BreinyFS/Breiny_Feliz_Electiva_2025_C1/Tareas clase #1/Resumen Cap 1 y 2 - Breiny Feěliz.pdf

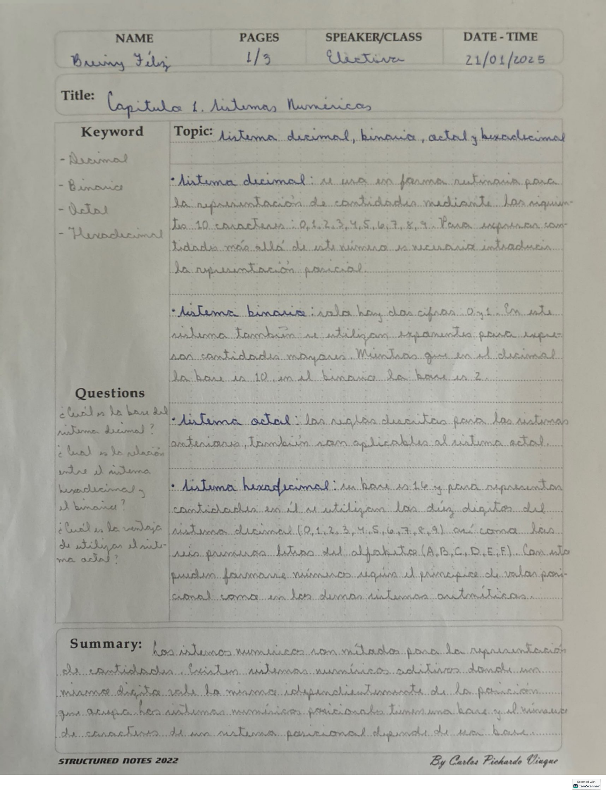
[picture p1: page 1]
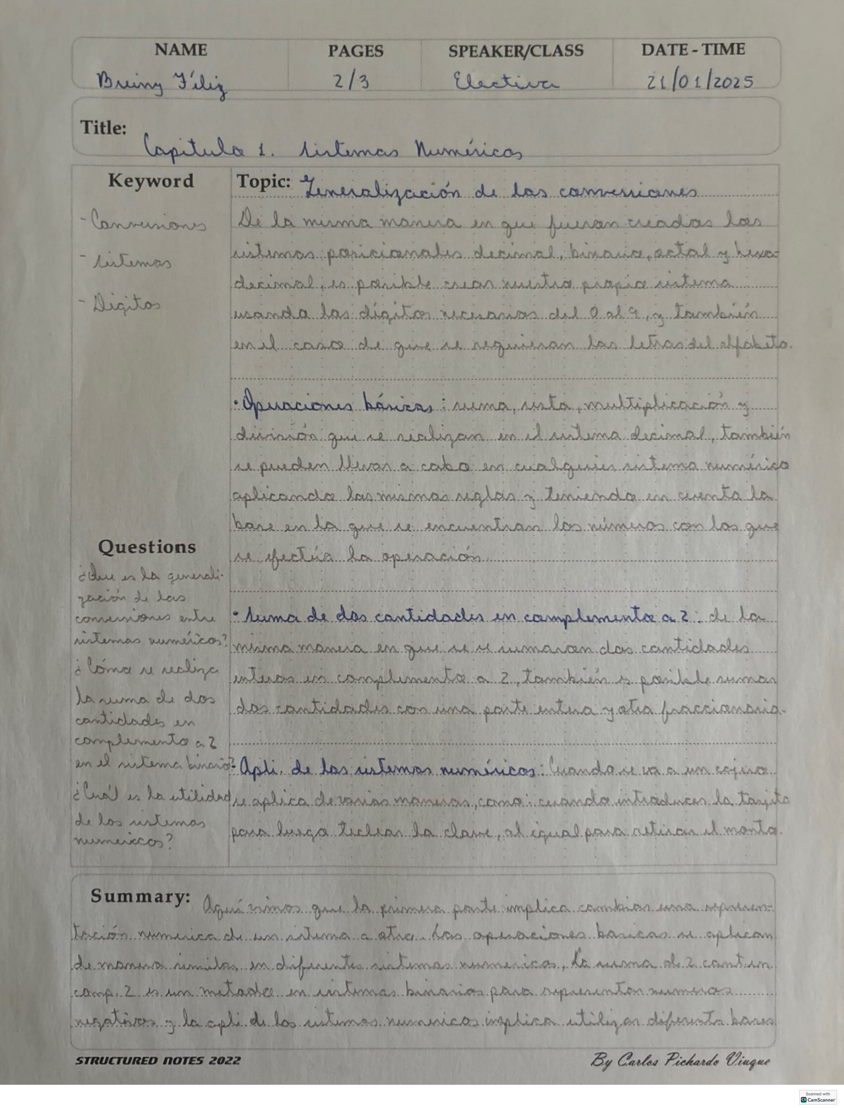
[picture p2: page 2]
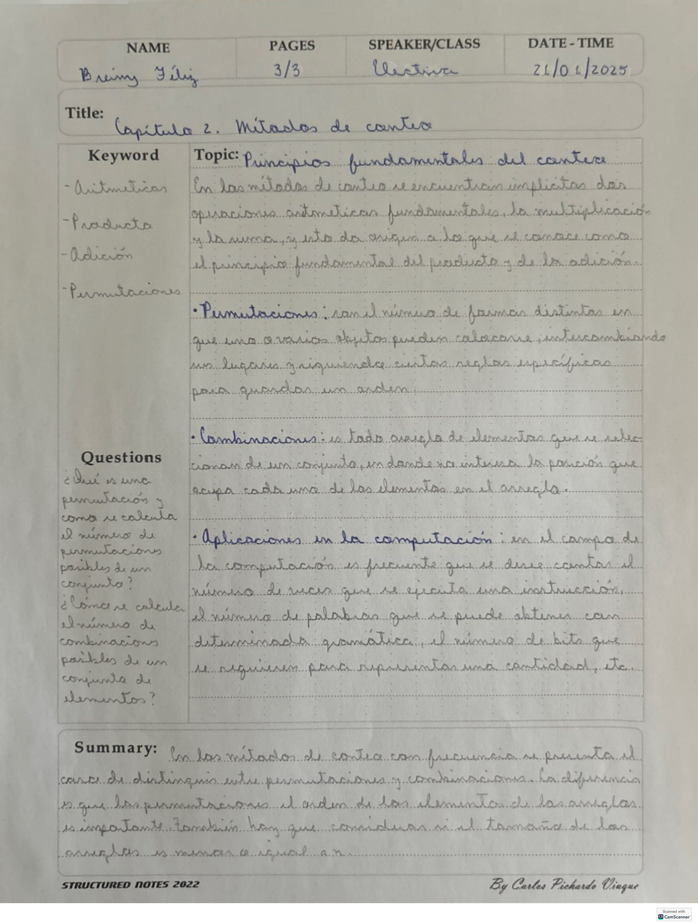
[picture p3: page 3]
