BreinyFS/Breiny_Feliz_Electiva_2025_C1/Tarea Final/Diseno en FreeCad/Parte Superior.FCStd

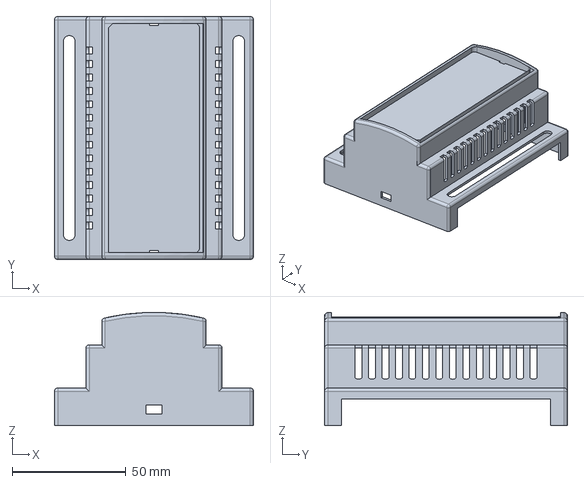
[picture p4: CAD file, 2025-04-25]
Tarea Final/Diseno en FreeCad/Parte Superior.FCStd
87.7 x 107.0 x 49.8 mm
