BreinyFS/Breiny_Feliz_Electiva_2025_C1/Tarea Final/Diseno en FreeCad/Parte Inferior.FCStd

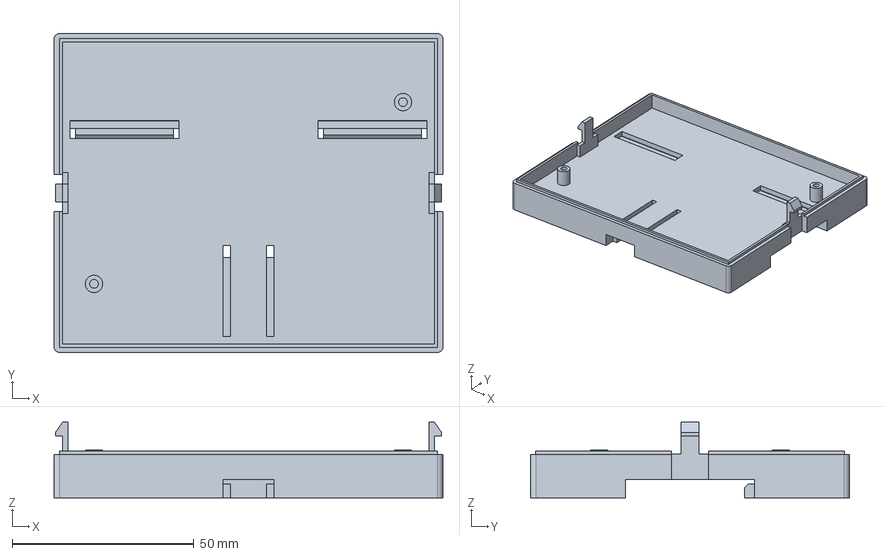
[picture p5: CAD file, 2025-04-22]
Tarea Final/Diseno en FreeCad/Parte Inferior.FCStd
107.0 x 87.7 x 20.8 mm
