BreinyFS/Breiny_Feliz_Electiva_2025_C1/Tarea #3/Aislador/Aislador.kicad_pcb

## KiCad design Tarea #3/Aislador/Aislador.kicad_pcb (2025-04-05)

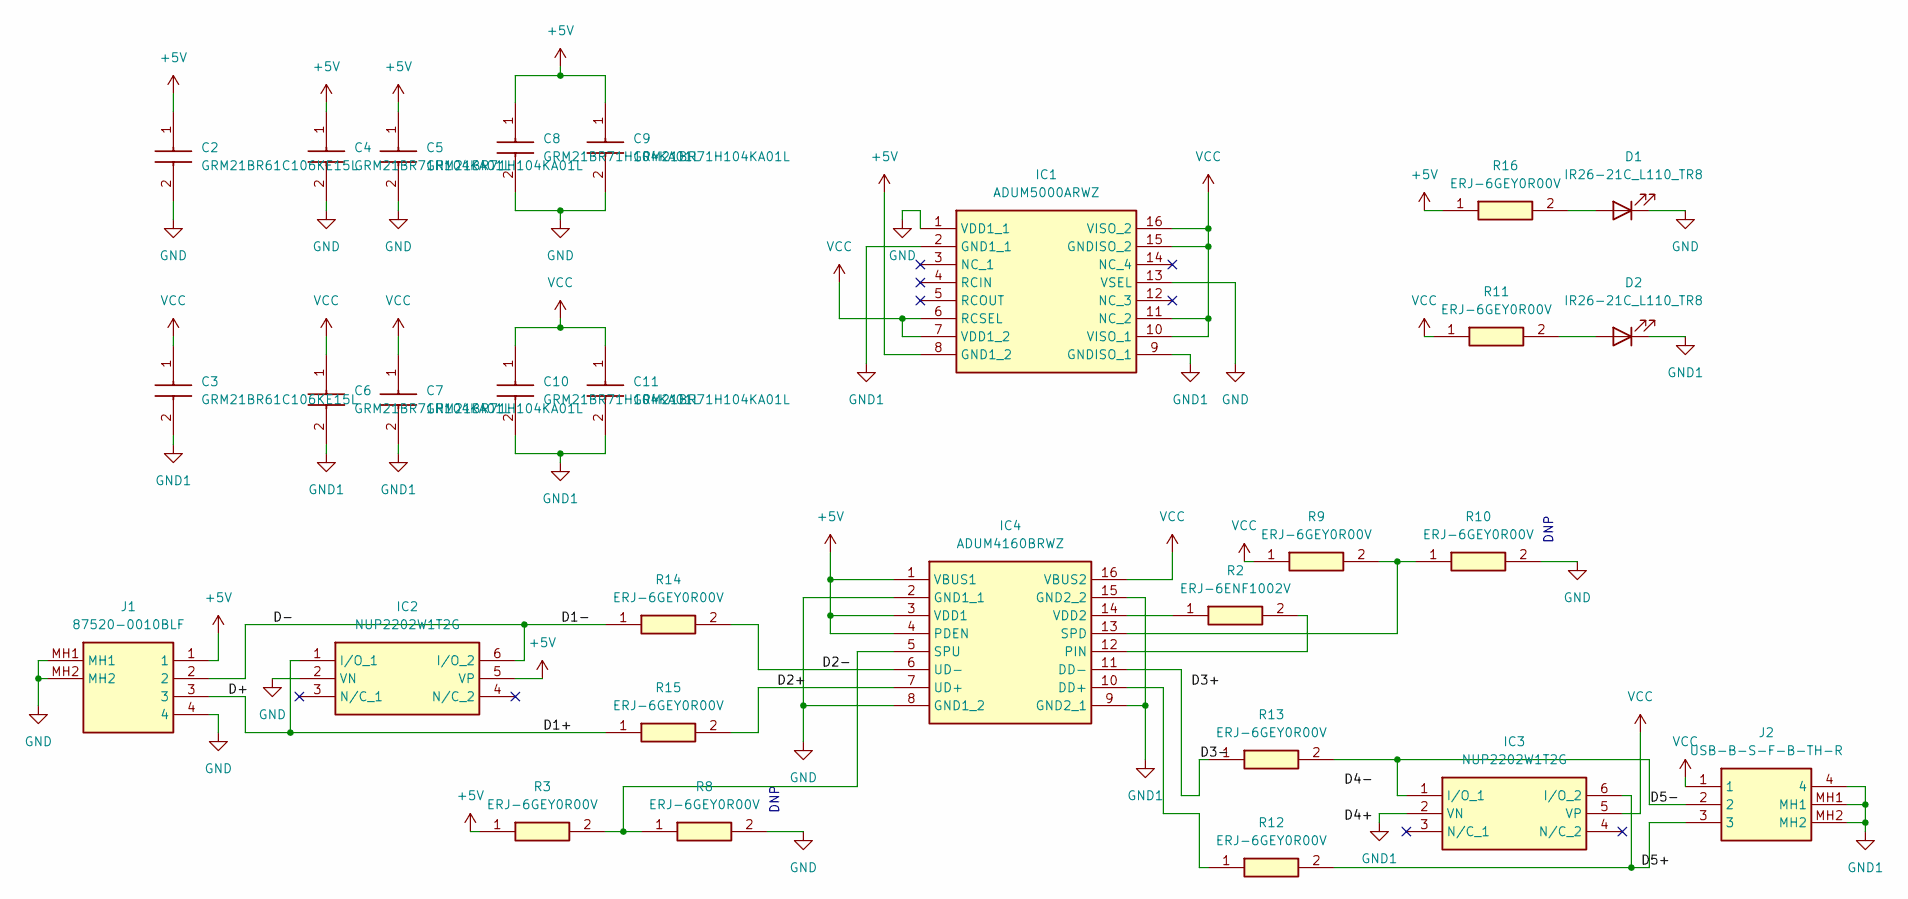
[picture p6: schematic Aislador.kicad_sch, Aislador USB]

Parts:
C2, C3: GRM21BR61C106KE15L; CAPC2012X145N; Manufacturer_Part_Number GRM21BR61C106KE15L; Mouser Part Number 81-GRM21BR61C106KE15
C4, C5, C6, C7, C8, C9, C10, C11: GRM21BR71H104KA01L; CAPC2012X145N; Manufacturer_Part_Number GRM21BR71H104KA01L; Mouser Part Number 81-GRM40X104K50L
D1, D2: IR26-21C_L110_TR8; LED_1206_3216Metric
IC1: ADUM5000ARWZ; SOIC127P1032X265-16N; Manufacturer_Part_Number ADUM5000ARWZ; Mouser Part Number 584-ADUM5000ARWZ
IC2, IC3: NUP2202W1T2G; SOT65P210X110-6N; Manufacturer_Part_Number NUP2202W1T2G; Mouser Part Number 863-NUP2202W1T2G
IC4: ADUM4160BRWZ; SOIC127P1032X265-16N; Manufacturer_Part_Number ADUM4160BRWZ; Mouser Part Number 584-ADUM4160BRWZ
J1: 87520-0010BLF; 875200010BLF; Manufacturer_Part_Number 87520-0010BLF
J2: USB-B-S-F-B-TH-R; USBBSFBTHR; Manufacturer_Part_Number USB-B-S-F-B-TH-R; Mouser Part Number 200-USBBSFBTHR
R2: ERJ-6ENF1002V; ERJ6ENF1000V; Manufacturer_Part_Number ERJ-6ENF1002V; Mouser Part Number 667-ERJ-6ENF1002V
R3, R8, R9, R10, R11, R12, R13, R14, R15, R16: ERJ-6GEY0R00V; RESC2012X70N; Manufacturer_Part_Number ERJ-6GEY0R00V; Mouser Part Number 667-ERJ-6GEY0R00V

Connections:
+5V: C2.1, C4.1, C5.1, C8.1, C9.1, IC1.8 (GND1_2), IC2.5 (VP), IC4.1 (VBUS1), IC4.3 (VDD1), IC4.4 (PDEN), J1.1, R3.1, R16.1
/D2+: IC4.7 (UD+), R15.2
/D2-: IC4.6 (UD-), R14.2
/D3-: IC4.11 (DD-), R13.1
/D5+: IC3.6 (I/O_2), J2.3, R12.2
/D5-: IC3.1 (I/O_1), J2.2, R13.2
/D+: IC2.1 (I/O_1), J1.3, R15.1
/D-: IC2.6 (I/O_2), J1.2, R14.1
GND: C2.2, C4.2, C5.2, C8.2, C9.2, D1.1 (K), IC1.1 (VDD1_1), IC1.13 (VSEL), IC2.2 (VN), IC4.2 (GND1_1), IC4.8 (GND1_2), J1.4, J1.MH1, J1.MH2, R8.2, R10.2
GND1: C3.2, C6.2, C7.2, C10.2, C11.2, D2.1 (K), IC1.2 (GND1_1), IC1.9 (GNDISO_1), IC3.2 (VN), IC4.9 (GND2_1), IC4.15 (GND2_2), J2.4, J2.MH1, J2.MH2
unnamed: D1.2 (A), R16.2
unnamed: D2.2 (A), R11.2
unnamed: IC4.10 (DD+), R12.1
unnamed: IC4.12 (PIN), R2.2
unnamed: IC4.13 (SPD), R9.2, R10.1
unnamed: IC4.5 (SPU), R3.2, R8.1
unnamed: IC4.14 (VDD2), R2.1
VCC: C3.1, C6.1, C7.1, C10.1, C11.1, IC1.6 (RCSEL), IC1.7 (VDD1_2), IC1.10 (VISO_1), IC1.11 (NC_2), IC1.15 (GNDISO_2), IC1.16 (VISO_2), IC3.5 (VP), IC4.16 (VBUS2), J2.1, R9.1, R11.1

Notes on the sheet:
DNP

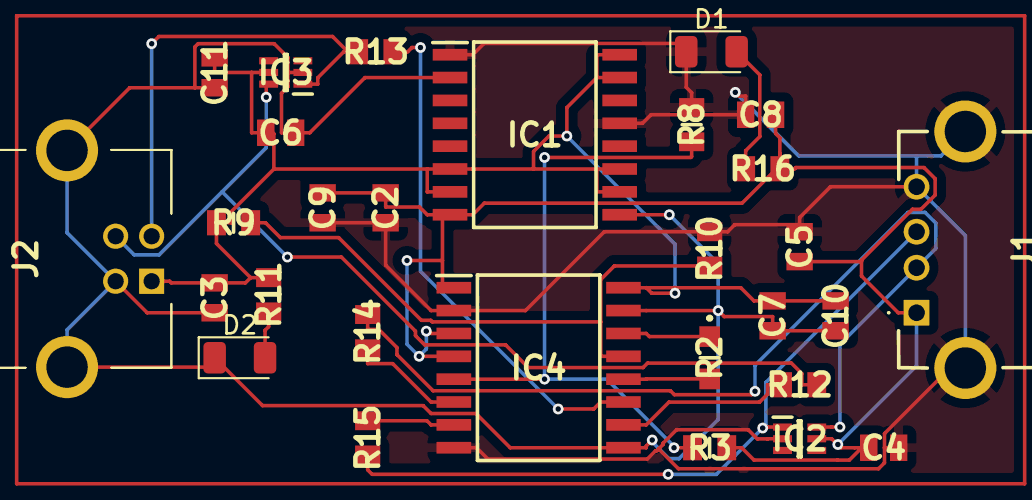
[picture p7: board Aislador.kicad_pcb from above]

Board: 2 copper layers, 29 parts (0 on the bottom side), 18 nets.
