BreinyFS/Breiny_Feliz_Electiva_2025_C1/Tareas clase #1/1- Modulo NRF24L01 2.4GHz/1- Modulo NRF24L01 2.4GHz.kicad_pcb

## KiCad design Tareas clase #1/1- Modulo NRF24L01 2.4GHz/1- Modulo NRF24L01 2.4GHz.kicad_pcb (2025-01-21)

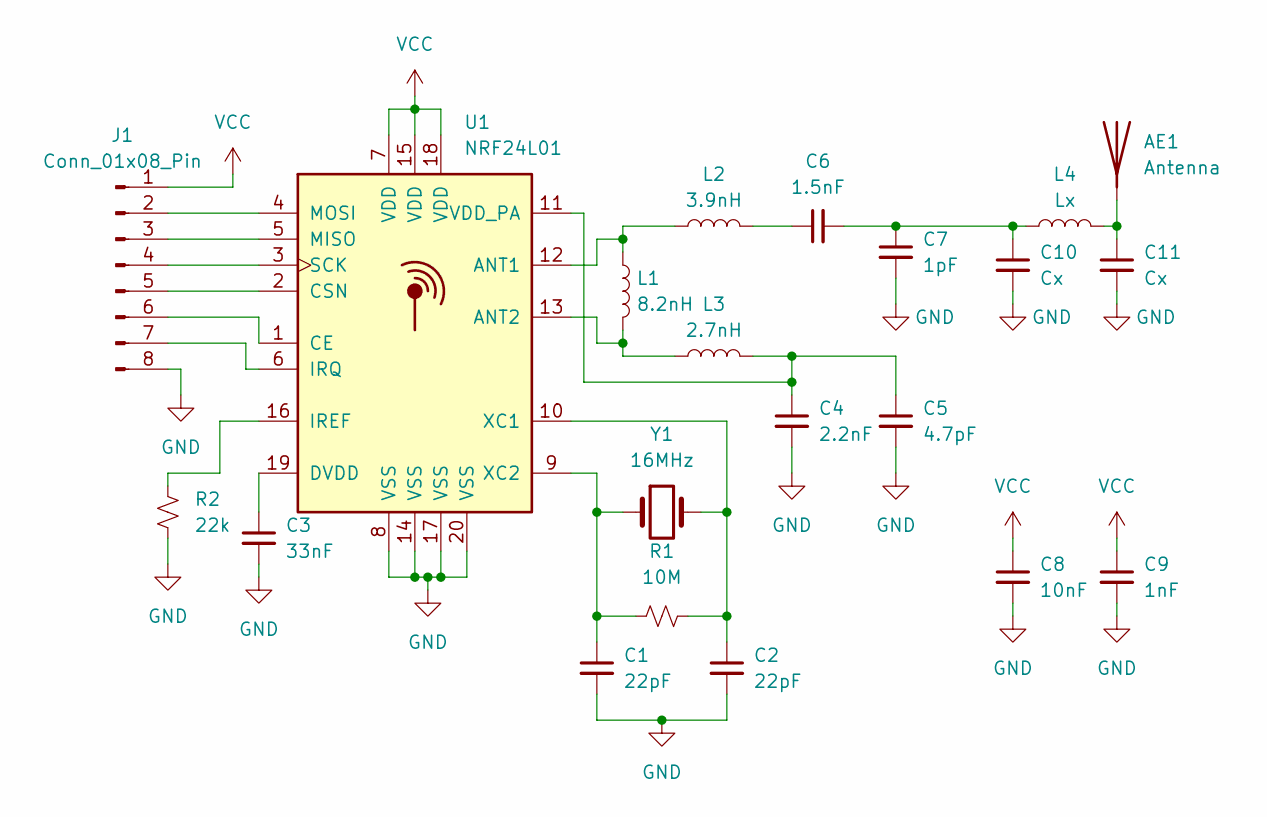
[picture p8: schematic 1- Modulo NRF24L01 2.4GHz.kicad_sch]

Parts:
AE1: Antenna; Texas_SWRA117D_2.4GHz_Right
C1, C2: 22pF; C_0402_1005Metric
C3: 33nF; C_0402_1005Metric
C4: 2.2nF; C_0402_1005Metric
C5: 4.7pF; C_0402_1005Metric
C6: 1.5nF; C_0402_1005Metric
C7: 1pF; C_0402_1005Metric
C8: 10nF; C_0402_1005Metric
C9: 1nF; C_0402_1005Metric
C10, C11: Cx; C_0402_1005Metric
J1: Conn_01x08_Pin; Hirose_DF13-08P-1.25DSA_1x08_P1.25mm_Vertical
L1: 8.2nH; L_0402_1005Metric
L2: 3.9nH; L_0402_1005Metric
L3: 2.7nH; L_0402_1005Metric
L4: Lx; L_0402_1005Metric
R1: 10M; R_0402_1005Metric
R2: 22k; R_0402_1005Metric
U1: NRF24L01; QFN-20-1EP_4x4mm_P0.5mm_EP2.5x2.5mm
Y1: 16MHz; Crystal_SMD_3215-2Pin_3.2x1.5mm

Connections:
GND: C1.2, C2.2, C3.2, C4.2, C5.2, C7.2, C8.2, C9.2, C10.2, C11.2, J1.8, R2.2, U1.8 (VSS), U1.14 (VSS), U1.17 (VSS), U1.20 (VSS)
unnamed: AE1.1 (A), C11.1, L4.2
unnamed: C6.1, L2.2
unnamed: C6.2, C7.1, C10.1, L4.1
unnamed: J1.2, U1.4 (MOSI)
unnamed: J1.3, U1.5 (MISO)
unnamed: J1.4, U1.3 (SCK)
unnamed: J1.5, U1.2 (CSN)
unnamed: J1.6, U1.1 (CE)
unnamed: J1.7, U1.6 (IRQ)
unnamed: L1.1, L2.1, U1.12 (ANT1)
unnamed: L1.2, L3.1, U1.13 (ANT2)
unnamed: C3.1, U1.19 (DVDD)
unnamed: R2.1, U1.16 (IREF)
unnamed: C4.1, C5.1, L3.2, U1.11 (VDD_PA)
unnamed: C2.1, R1.2, U1.10 (XC1), Y1.2
unnamed: C1.1, R1.1, U1.9 (XC2), Y1.1
VCC: C8.1, C9.1, J1.1, U1.7 (VDD), U1.15 (VDD), U1.18 (VDD)

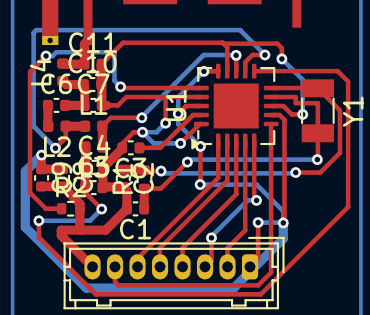
[picture p9: board 1- Modulo NRF24L01 2.4GHz.kicad_pcb from above]

Board: 2 copper layers, 21 parts (0 on the bottom side), 18 nets.
