BreinyFS/Breiny_Feliz_Electiva_2025_C1/(commit log)

2025-01-21 1- Modulo NRF24L01 2.4GHz
    [1- Modulo NRF24L01 2.4GHz.kicad_pcb, 1- Modulo NRF24L01 2.4GHz.kicad_sch]
2025-03-13 Create DOC - Plantilla Para Desarrollo de Producto Basada Norma IEEE-830 STD - Breiny Feliz.docx
    Plantilla de desarrollo
2025-03-13 Update DOC - Plantilla Para Desarrollo de Producto Basada Norma IEEE-830 STD - Breiny Feliz.docx
    Parte #1
2025-03-14 Update DOC - Plantilla Para Desarrollo de Producto Basada Norma IEEE-830 STD - Breiny Feliz.docx
    Parte #2
2025-03-19 Update DOC - Plantilla Para Desarrollo de Producto Basada Norma IEEE-830 STD - Breiny Feliz.docx
    Parte 3 y 4 completadas
2025-03-19 Tarea #3
    Aislador
    [Aislador.kicad_pcb, Aislador.kicad_sch]
2025-03-19 Create Resumen de Inscripcion.pdf
2025-03-19 Tarea #3
    [Aislador.kicad_pcb, Aislador.kicad_sch]
2025-04-19 Tarea Final
    [Parte Inferior.FCStd, Parte Superior.FCStd]
